bsulkowski/maze-cubed/README.md

# Maze³

**English** · [Polski](README.pl.md)

The classic maze, generalised to three dimensions: cubic cells, passages in
all six directions, no privileged axis. A ball travels inside, and you turn
the cube every way to lead it from the entrance to the exit.

A space like this opens possibilities a flat maze doesn't have — for
example, the route through the maze can tie itself into a knot. In
`lab4_1` the route from entrance to exit, closed up outside the cube, forms
a trefoil.

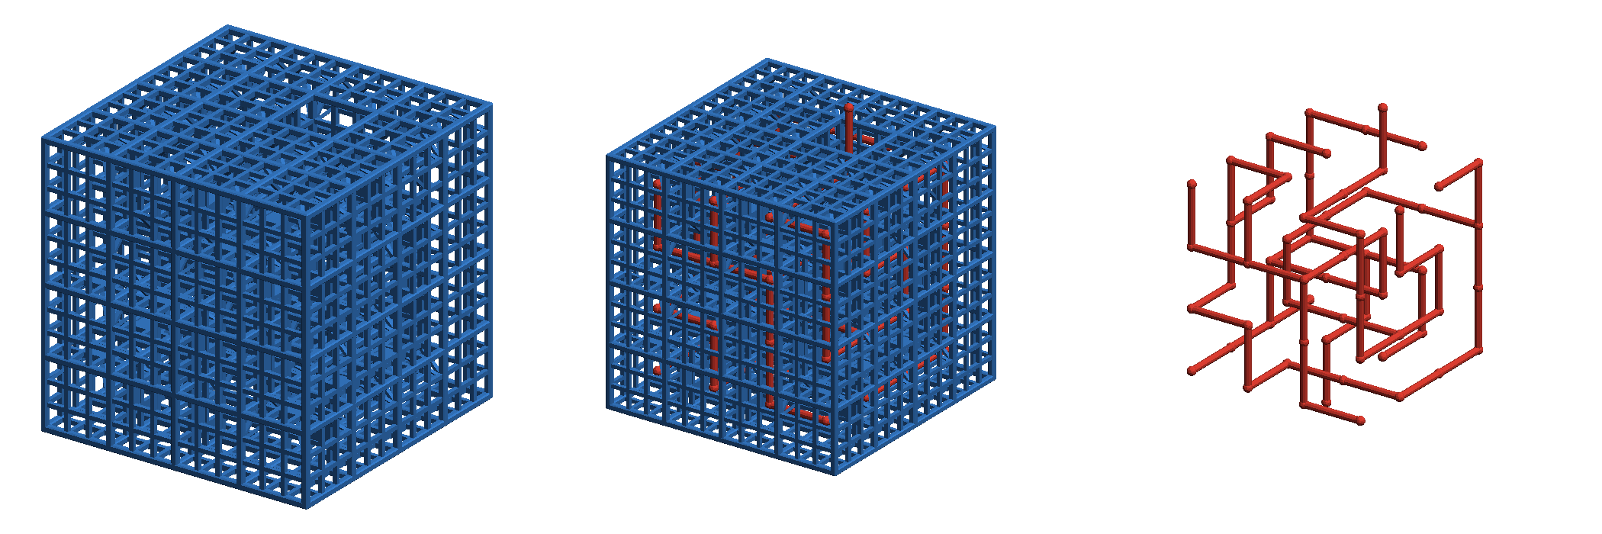
[picture p1: images/lab4_1.png]
Maze lab4_1: model, model with routes, routes alone


## Mazes

| File | Size | Route | Branches | Knot | Notes |
|---|---|---|---|---|---|
| `lab2_1` | 2×2×2, 52 mm, ~16 g | 8 of 8 cells | 0 | — | print test only |
| `lab3_1` | 3×3×3, 77 mm, ~46 g | 14 of 27 cells | 5 | — | warm-up |
| `lab334_1` | 3×3×4, 77×77×102 mm, ~61 g | 19 of 36 cells | 6 | — | a step up |
| `lab344_1` | 3×4×4, 77×102×102 mm, ~79 g | 21 of 48 cells | 8 | — | long dead ends |
| `lab4_1` | 4×4×4, 102 mm, ~102 g | 39 of 64 cells | 9 | trefoil | the main challenge |
| `lab345_1` | 3×4×5, 77×102×127 mm, ~97 g | 39 of 60 cells | 9 | trefoil | unequal sides help orientation |

Weights are for PLA. Every maze is *perfect*: every cell is reachable, there
are no loops, and there is exactly one route from the entrance to the exit.
Ready-to-print STL and 3MF files are in `models/`.

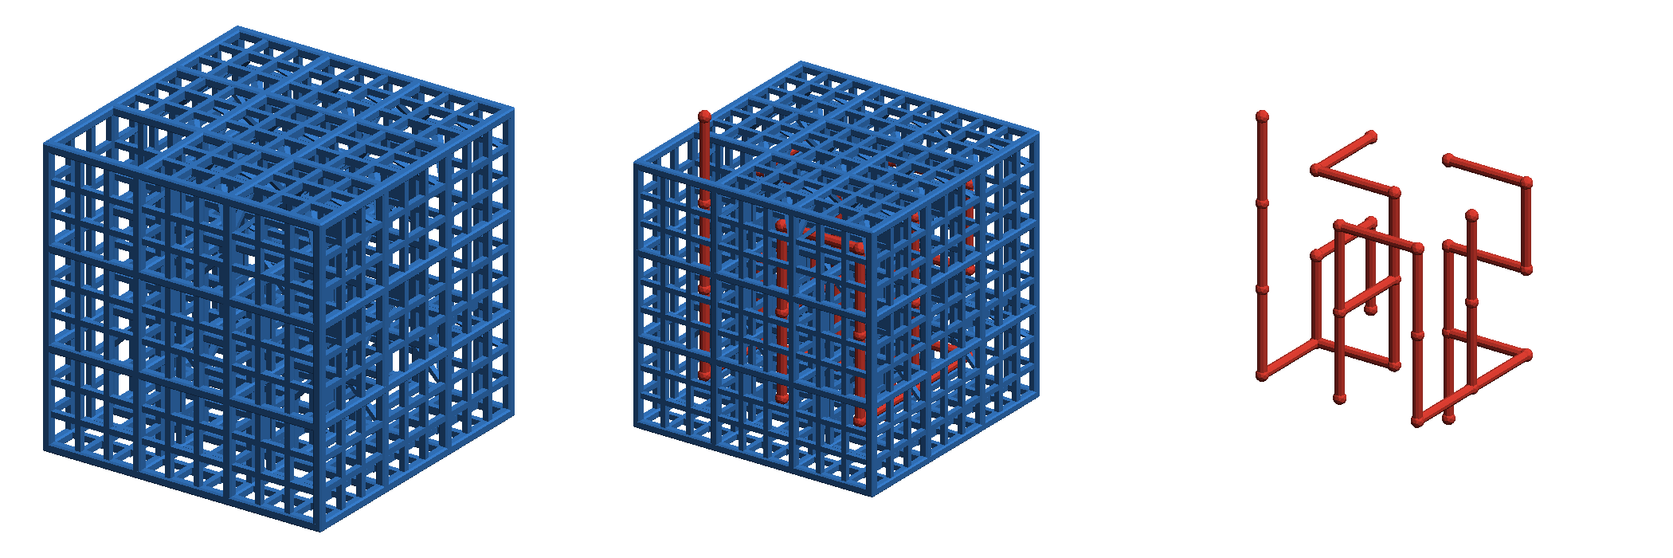
[picture p2: images/lab3_1.png]
Maze lab3_1


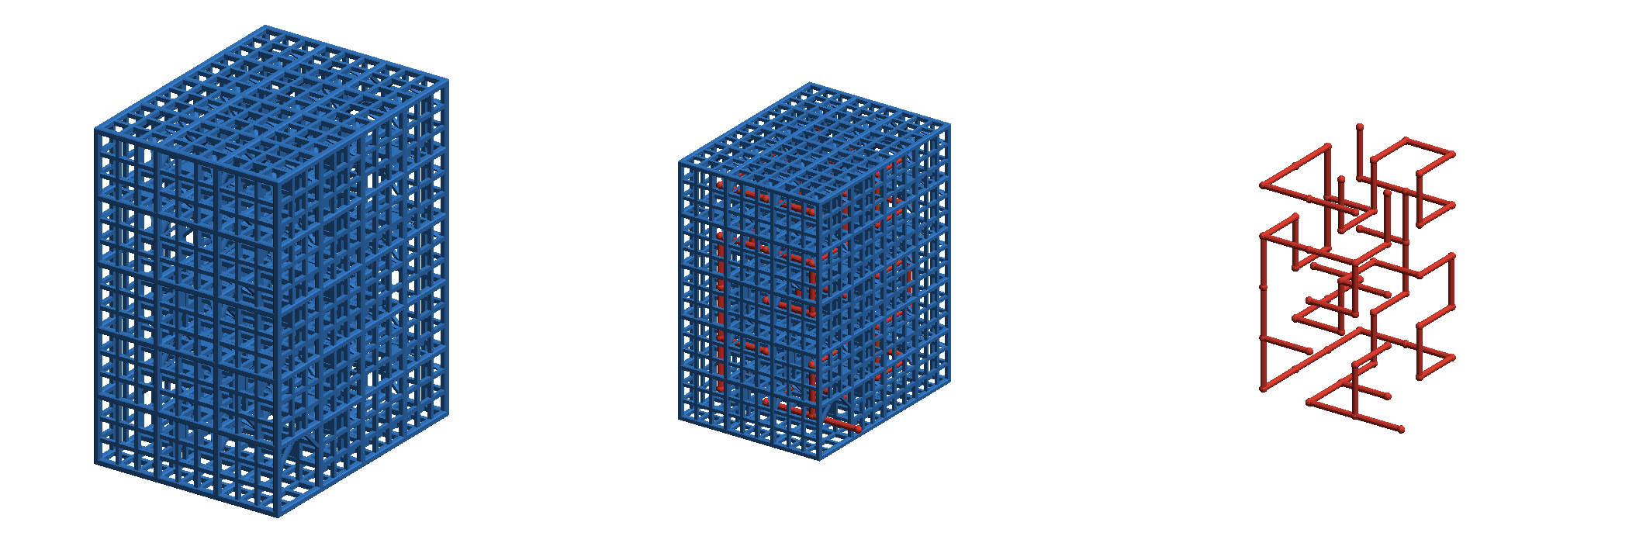
[picture p3: images/lab345_1.png]
Maze lab345_1


## How to play

Every maze has two openings to the outside — in `lab2_1`, `lab3_1` and
`lab4_1` one in the bottom face and one on top, in `lab334_1` and
`lab344_1` one on each of the opposite 3×4 sides, in `lab345_1` one on
each of the large 4×5 sides. Either can be the entrance: drop the ball into
one, then tilt, turn and flip the cube until it comes out of the other.

The ball has a hole through it — Ariadne's thread: pass a thread or a thin
tape through it, and the thread trails behind the ball and shows the way
it has come.

## Printing

- No supports. Print in the orientation from the file.
- Default dimensions are made for a 0.4 mm nozzle: frame bars 2.4 mm
  (6 lines), window grid 1.6 mm (4 lines), 0.4 mm chamfer.
- Every horizontal wall rests on diagonal braces and small pads placed
  exactly under its bridges. The longest bridges are about 8.3 mm
  centre to centre (6.7 mm clear).
- Braces are about 35° from horizontal; good part cooling helps. Their
  undersides may come out slightly rough, which doesn't affect play.
- Designed for a Bambu Lab A1 mini; all models fit its 180 mm build
  volume.

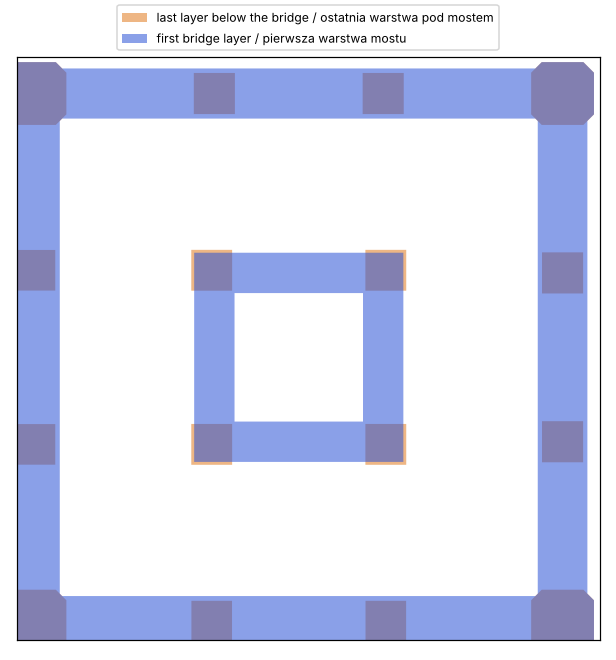
[picture p4: images/bridge_support.png]
Bridge support: brace tops sit exactly under the corners of the pad, where the bridge starts


## The ball

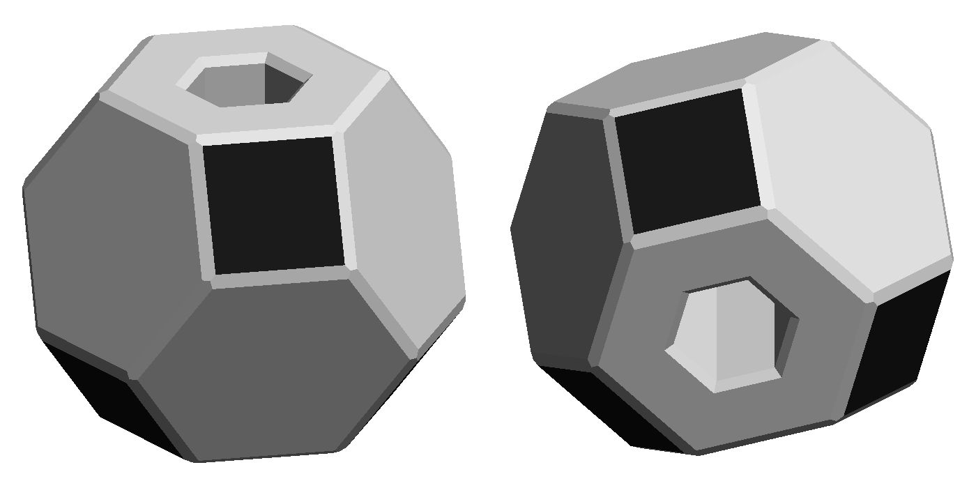
[picture p5: images/ball.png]
Ball


`ball.py` makes a truncated octahedron cut from a 20 mm cube: the cube's
edges and corners cut away, leaving 6 squares and 8 hexagons. It prints
standing on a hexagon without supports (`--on square` for a square face)
and rolls well. All its edges are chamfered by 0.4 mm, like the bars
(`--chamfer`). Straight through the centre, between two opposite hexagons,
runs a hexagonal 5 mm hole for a thread, countersunk at both ends
(`--hole`, `--hole 0` for none). The passages let through a ball of up to
21 mm, so 19–20 mm works best. The cube size is set with `--cube`.

## The knot

The route through the maze starts and ends outside the cube, so closing
it with an arc outside the cube is unambiguous and the loop has a
well-defined knot type. `tools/knot.py` finds the route, closes it, and
computes the Alexander polynomial in several random projections:

```
$ python tools/knot.py mazes/lab4_1.txt
route: 39 cells, from (2, 3, 0) to (3, 3, 5)
projection 0: crossings   9  Δ(t) = t**2 - t + 1   |Δ(−1)| = 3
...
result: trefoil (3₁)
```

A flat maze can't do this: a curve needs three dimensions to be knotted.

## Generator

```sh
pip install -r requirements.txt

python maze_cubed.py mazes/lab4_1.txt     # maze → models/lab4_1.stl, .3mf
python maze_cubed.py --size 4 4 4         # full lattice, no passages
python ball.py                            # ball → models/ball_20mm.stl, .3mf
python tools/knot.py mazes/lab4_1.txt     # knot type of the route
python tools/preview.py models/lab4_1.stl --paths mazes/lab4_1.txt -o images/lab4_1.png
```

The generator also checks the maze itself: whether it covers every cell,
whether it is connected and loop-free, and how many exits it has.

### Path file format

A list of paths, each a list of consecutive cells `[x, y, z]`. Inner cells
have coordinates from 1 to N; 0 or N+1 means an exit to the outside. The
wall between two consecutive cells of a path is open. Branches are written
as separate paths starting from an already visited cell.

```js
pass4x = [
	[ [2, 3, 0], [2, 3, 1], [2, 4, 1], /* … */ [3, 3, 5] ],
	[ [2, 4, 2], [3, 4, 2], [3, 4, 1], [3, 3, 1] ],
	/* … */
];
```

The lattice size is inferred from the paths; it can also be given
explicitly with `--size NX NY NZ`.

### Random mazes

`tools/random_maze.py` generates perfect mazes (uniform random spanning
trees, Wilson's algorithm) and picks the layout that best fits the
criteria: the route goes in all six directions, its length is in a given
range, dead ends are longer rather than single cells, the entrance and
exit are on opposite faces, and optionally the route is (or isn't)
knotted. A given `--seed` always produces the same maze.

```sh
python tools/random_maze.py --size 2 2 2 --seed 3 --min-len 0.5 --max-len 1 -o mazes/lab2_1.txt
python tools/random_maze.py --size 3 3 3 --seed 1 --knot unknot -o mazes/lab3_1.txt
python tools/random_maze.py --size 3 3 4 --seed 5 -o mazes/lab334_1.txt
python tools/random_maze.py --size 3 4 4 --seed 1 -o mazes/lab344_1.txt
python tools/random_maze.py --size 3 4 5 --seed 1 --tries 300 --knot knotted -o mazes/lab345_1.txt
```

A random tree practically never knots its route, so `--knot knotted`
works the other way round: it samples a
strongly tangled Hamiltonian path through the whole lattice (a snake
shuffled with backbite moves), cuts out a segment between opposite faces
whose knot determinant isn't 1, and only then grows the rest of the maze
around it. `--det 5` asks for a figure-eight knot, but at this size it
practically never comes up.

`lab4_1` is the original layout; `lab2_1`, `lab3_1`, `lab334_1`,
`lab344_1` and `lab345_1` were generated with the commands above.

### Construction

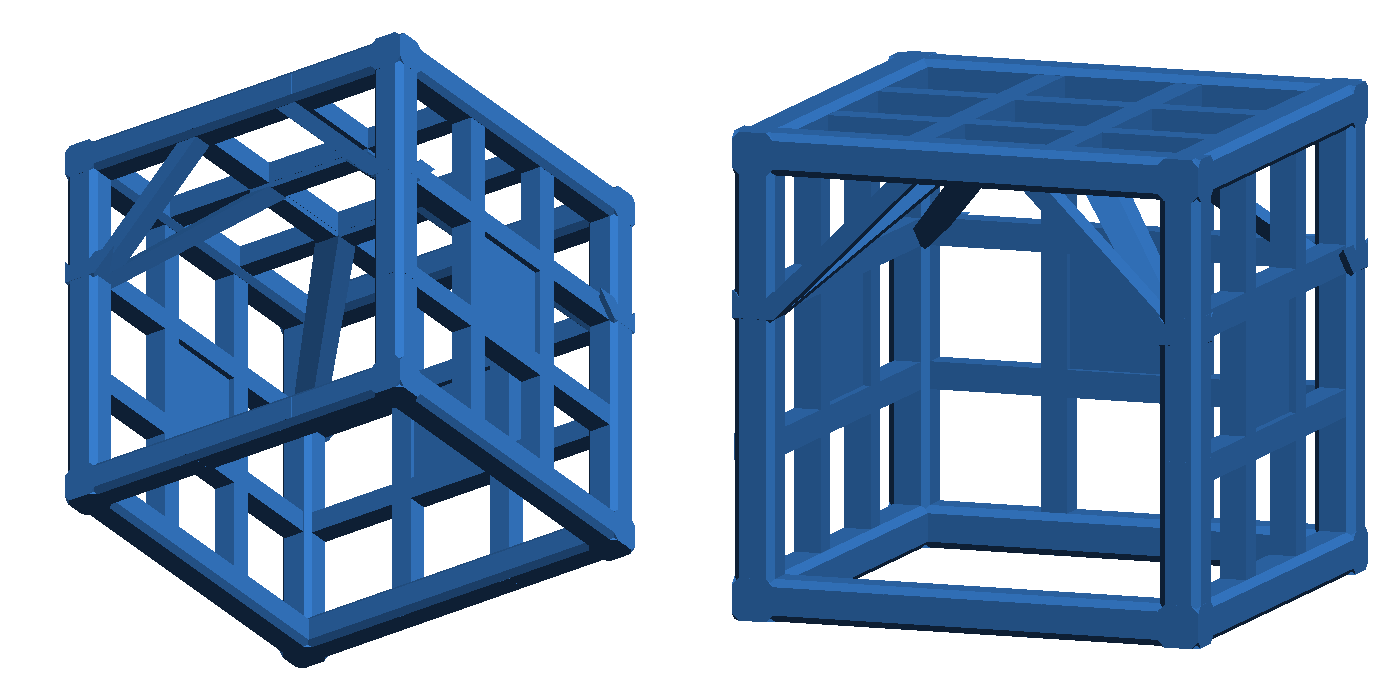
[picture p6: images/cell.png]
A single cell with an open side wall


- **Lattice:** square bars with chamfered edges, 25 mm between axes.
- **Walls:** a grid of square muntins dividing each window into 3 × 3
  panes, centred in the plane of the bars. Open walls have no grid.
- **Plates:** in every closed inner wall the middle pane is filled with a
  0.8 mm plate. The walls inside the maze stand out, and as the cube turns,
  plates at different depths shift against each other, which shows how
  deep they lie. The outer walls of the cube have no plates.
- **Ceiling braces:** 4 per cell, diagonal in plan, from the muntin
  crossings of the ceiling to the nearest corner post. They disappear only
  together with the ceiling. Every horizontal section of a brace is a
  square aligned with the lattice (rotated 45° relative to the brace's own
  axis), and its top lies at the underside of the pad, where the bridge
  starts — under the muntin crossing. Towards the top the brace widens by
  0.4 mm: a slicer takes each layer's outline from the middle of the
  layer, where a leaning brace has already moved outwards, and the
  widening keeps the last layers under the bridge covering the whole
  crossing.
- **Knee braces:** two 45° braces under the top bar of every open side
  wall, ending under the bar above the outer muntin lines. Ceiling braces
  and knee braces meet the posts at the same height.
- **Pads:** under every closed horizontal wall, the frame of the middle
  pane extends down to the level of the bar undersides (one chamfer below
  the muntins). On the bottom face it rests on the print bed.

Bar, chamfer, muntin, cell size and plate thickness can be changed on the
command line (`--rod`, `--chamfer`, `--muntin`, `--edge`, `--plate`;
`--plate 0` leaves the panes empty); the output file then gets a suffix,
e.g. `lab3_1_edge20_plate0`. A muntin can't be wider
than the flat part of a bar (bar − 2 × chamfer).

Touching elements differ in size by a few to a few dozen micrometres
(`EPS`), so that no two faces are coplanar and no face lies on another
element's edge. This keeps the mesh watertight, with no duplicate
vertices, for any dimensions. `EPS` is deliberately not a round number, so
its small multiples never cancel out with round dimensions.

## Repository layout

| Path | Contents |
|---|---|
| `maze_cubed.py` | maze generator (STL + 3MF) |
| `ball.py` | the ball |
| `mazes/` | maze layouts (path files) |
| `models/` | ready-to-print models |
| `tools/knot.py` | knot type of the route |
| `tools/random_maze.py` | random maze in the path file format |
| `tools/preview.py`, `tools/render.py` | PNG previews |
| `images/` | previews |
| `LICENSE` | MIT licence |

## Licence

[MIT](LICENSE) — covers the code and the generated models.
