bsulkowski/maze-cubed/images/lab3_1_rod2.4_chamfer0.4_muntin1.6.png

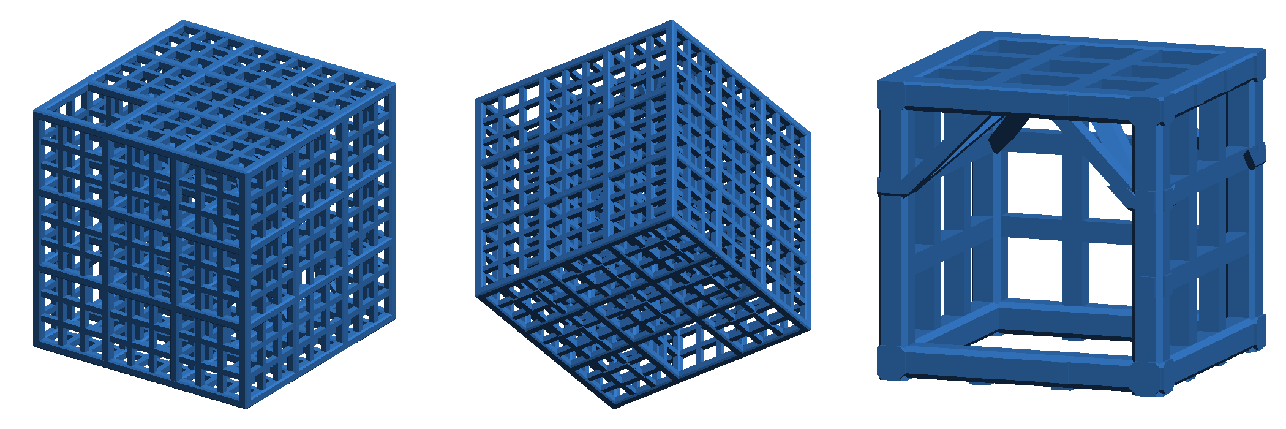
images/lab3_1_rod2.4_chamfer0.4_muntin1.6.png
