bsulkowski/maze-cubed/images/lab3_1_rod3_muntin2.png

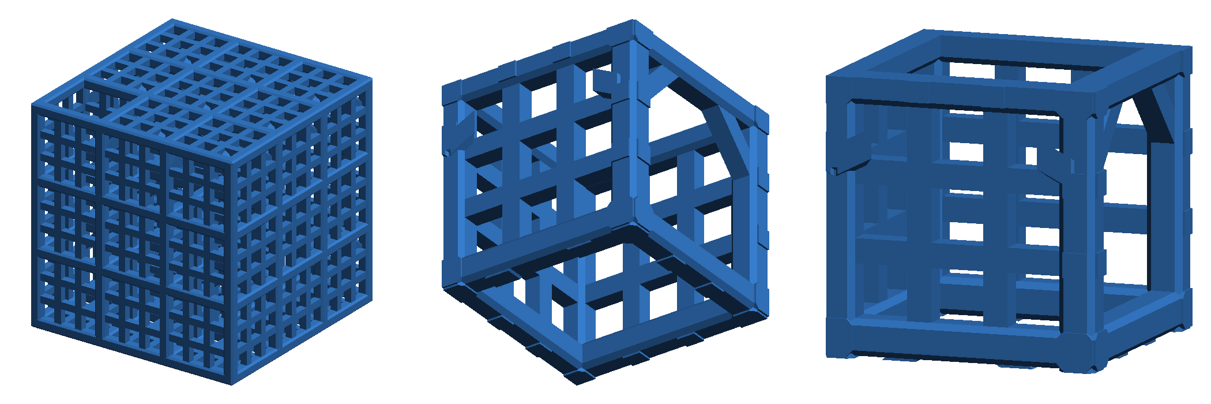
images/lab3_1_rod3_muntin2.png
