bsulkowski/maze-cubed/models/lab2_1.3mf

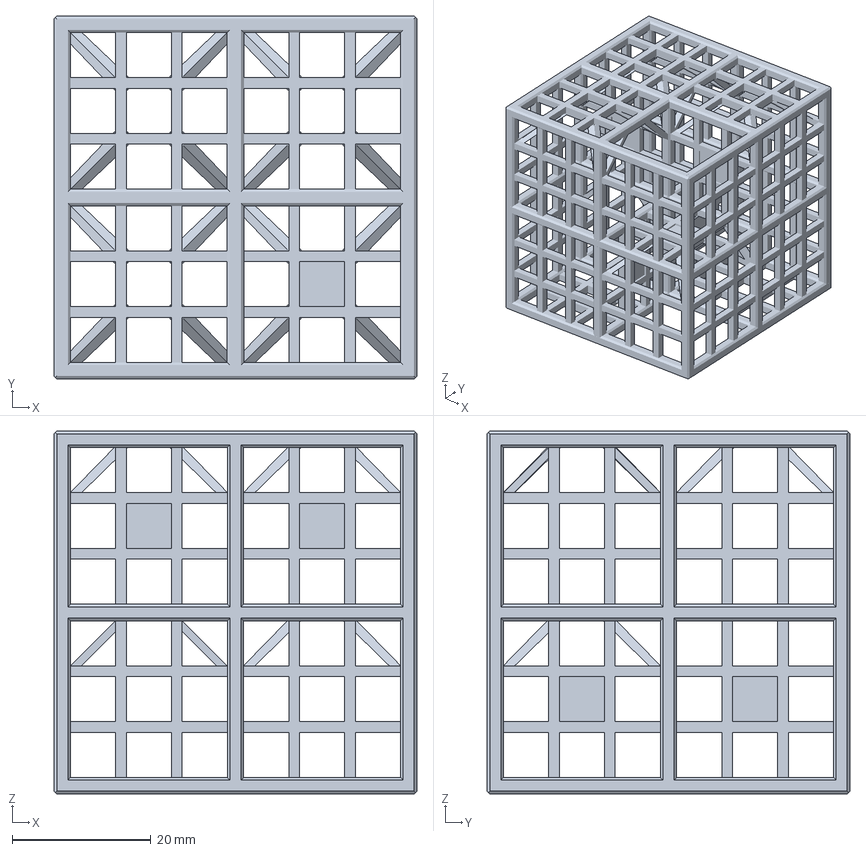
[picture p9: CAD file, 2026-10-20]
models/lab2_1.3mf
52.4 x 52.4 x 52.4 mm
