bsulkowski/maze-cubed/models/lab344_1.3mf

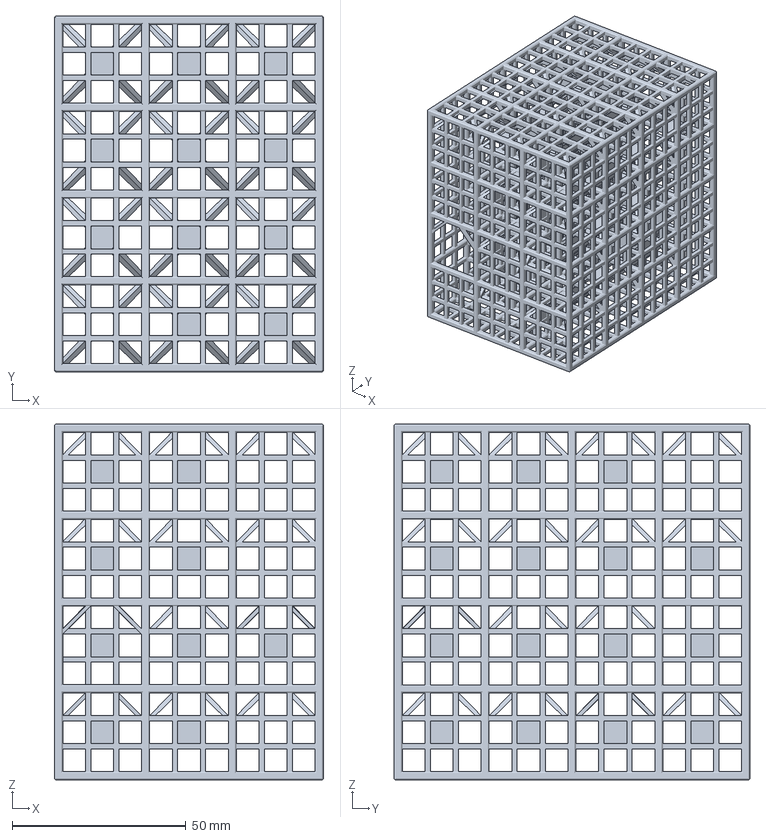
[picture p10: CAD file, 2026-10-20]
models/lab344_1.3mf
77.4 x 102.4 x 102.4 mm
