bsulkowski/maze-cubed/models/lab334_1.3mf

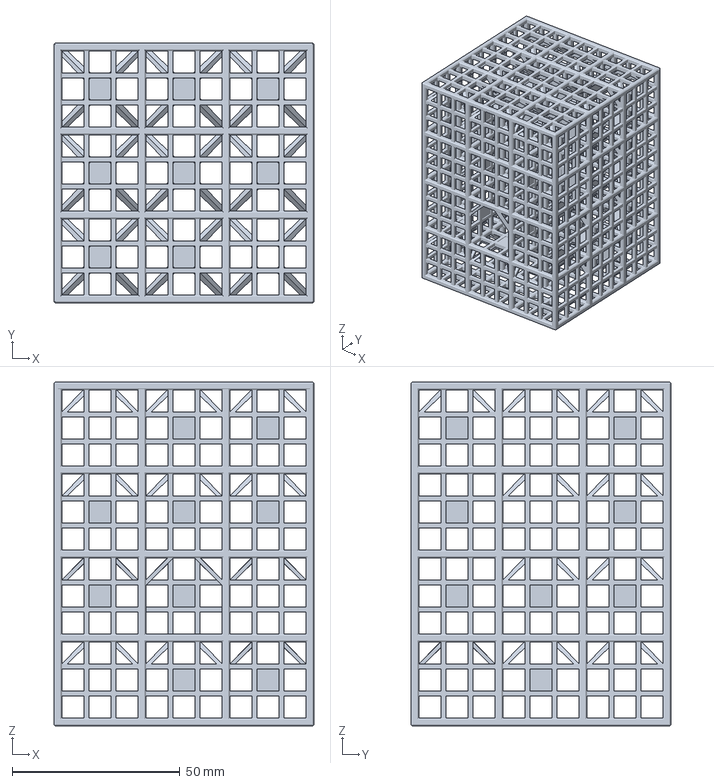
[picture p11: CAD file, 2026-10-20]
models/lab334_1.3mf
77.4 x 77.4 x 102.4 mm
