bsulkowski/maze-cubed/models/lab4_1.3mf

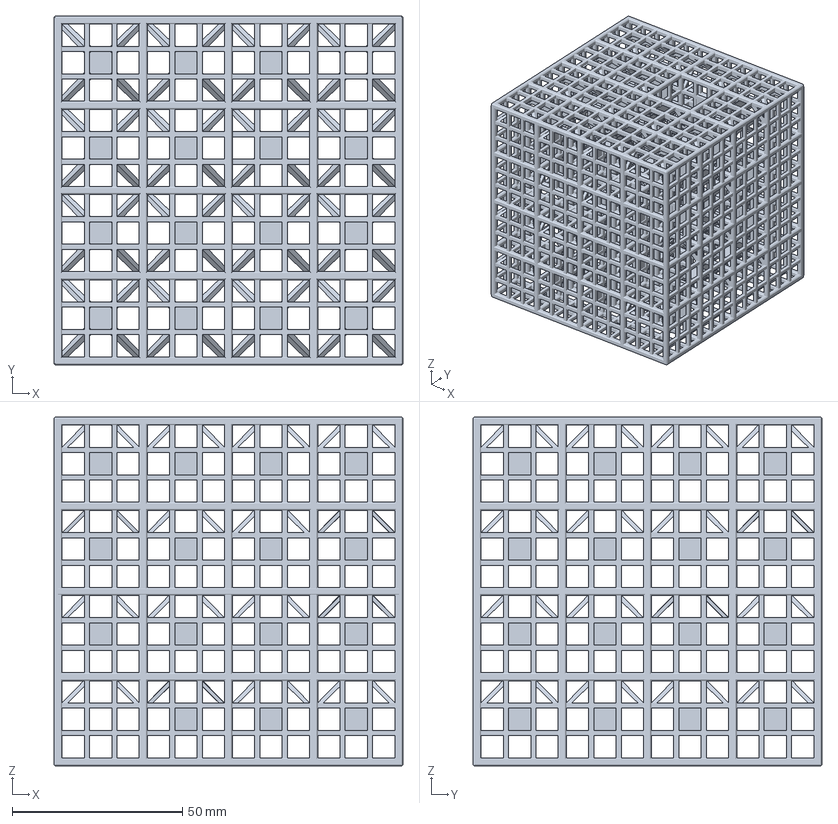
[picture p12: CAD file, 2026-10-20]
models/lab4_1.3mf
102.4 x 102.4 x 102.4 mm
