bsulkowski/maze-cubed/models/lab345_1.3mf

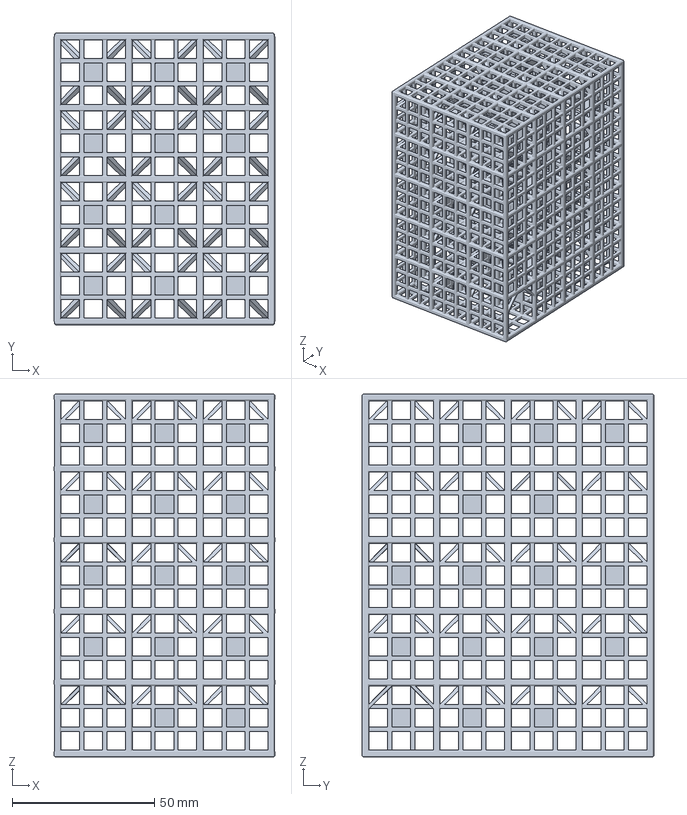
[picture p13: CAD file, 2026-10-20]
models/lab345_1.3mf
77.4 x 102.4 x 127.4 mm
