bsulkowski/maze-cubed/models/lab3_1.3mf

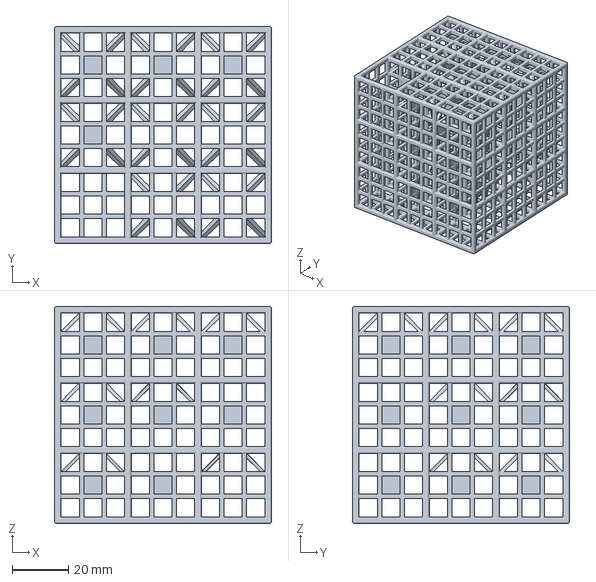
[picture p14: CAD file, 2026-10-20]
models/lab3_1.3mf
77.4 x 77.4 x 77.4 mm
