bsulkowski/maze-cubed/models/ball_20mm.3mf

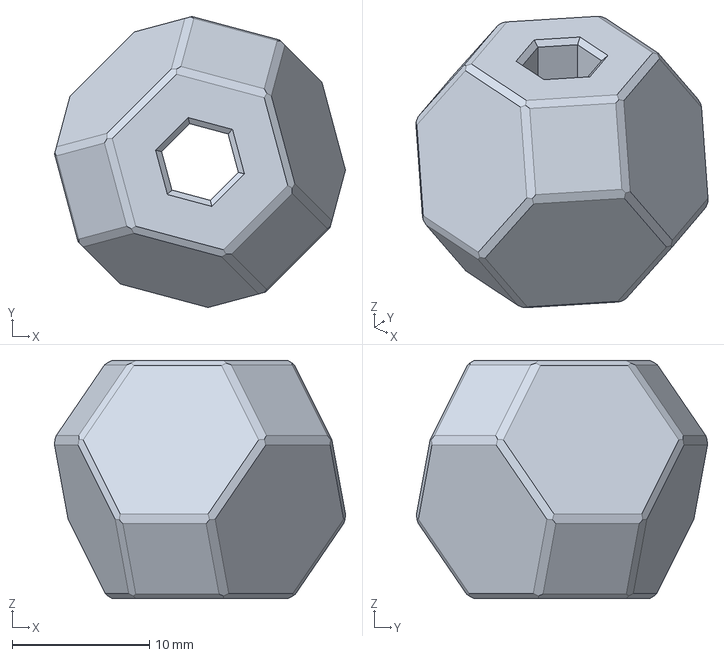
[picture p15: CAD file, 2026-10-20]
models/ball_20mm.3mf
21.2 x 21.2 x 17.3 mm
