bsulkowski/maze-cubed/models/ball_16mm.3mf

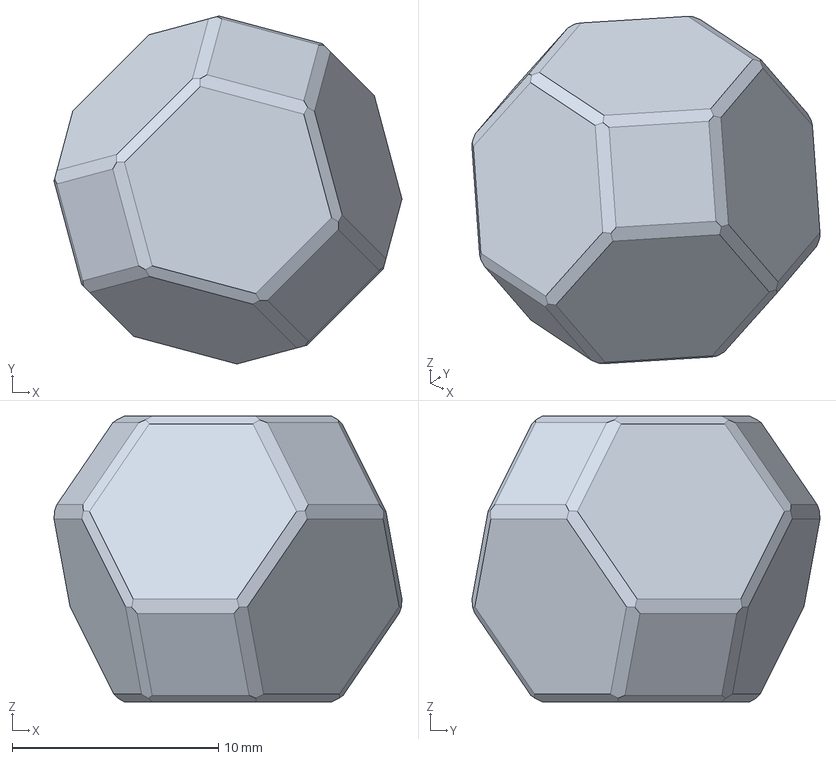
[picture p16: CAD file, 2026-10-19]
models/ball_16mm.3mf
16.9 x 16.9 x 13.9 mm
