bsulkowski/maze-cubed/models/lab4_1_rod2.4_chamfer0.4_muntin1.6.3mf

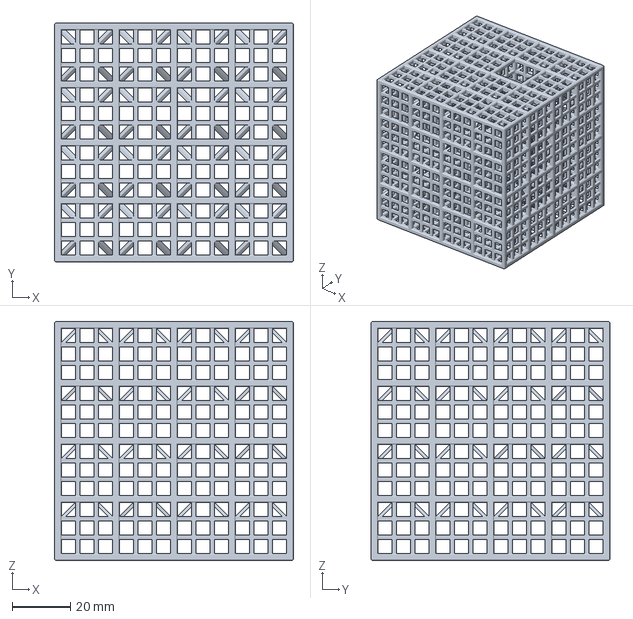
[picture p17: CAD file, 2026-10-14]
models/lab4_1_rod2.4_chamfer0.4_muntin1.6.3mf
82.4 x 82.4 x 82.4 mm
