bsulkowski/maze-cubed/models/lab2_1_rod2.4_chamfer0.4_muntin1.6.3mf

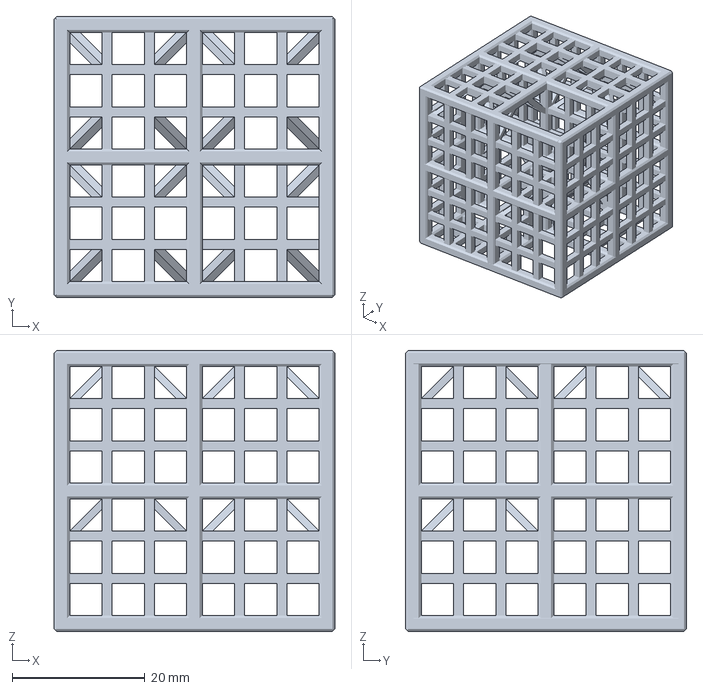
[picture p18: CAD file, 2026-10-13]
models/lab2_1_rod2.4_chamfer0.4_muntin1.6.3mf
42.4 x 42.4 x 42.4 mm
