bsulkowski/maze-cubed/models/lab3_1_rod2.4_chamfer0.4_muntin1.6.3mf

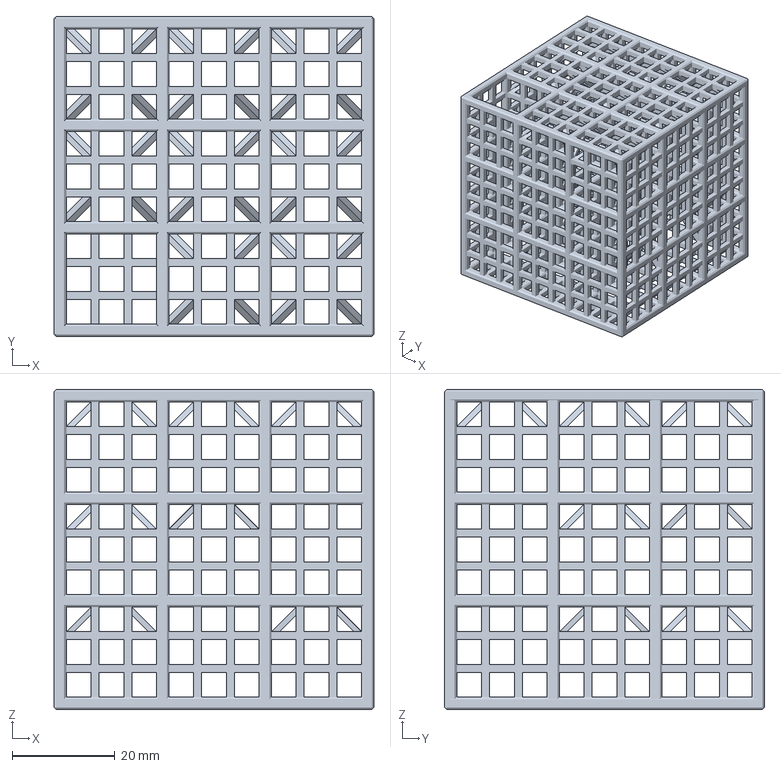
[picture p19: CAD file, 2026-10-13]
models/lab3_1_rod2.4_chamfer0.4_muntin1.6.3mf
62.4 x 62.4 x 62.4 mm
