bsulkowski/maze-cubed/models/lab3_1_rod3_muntin2.3mf

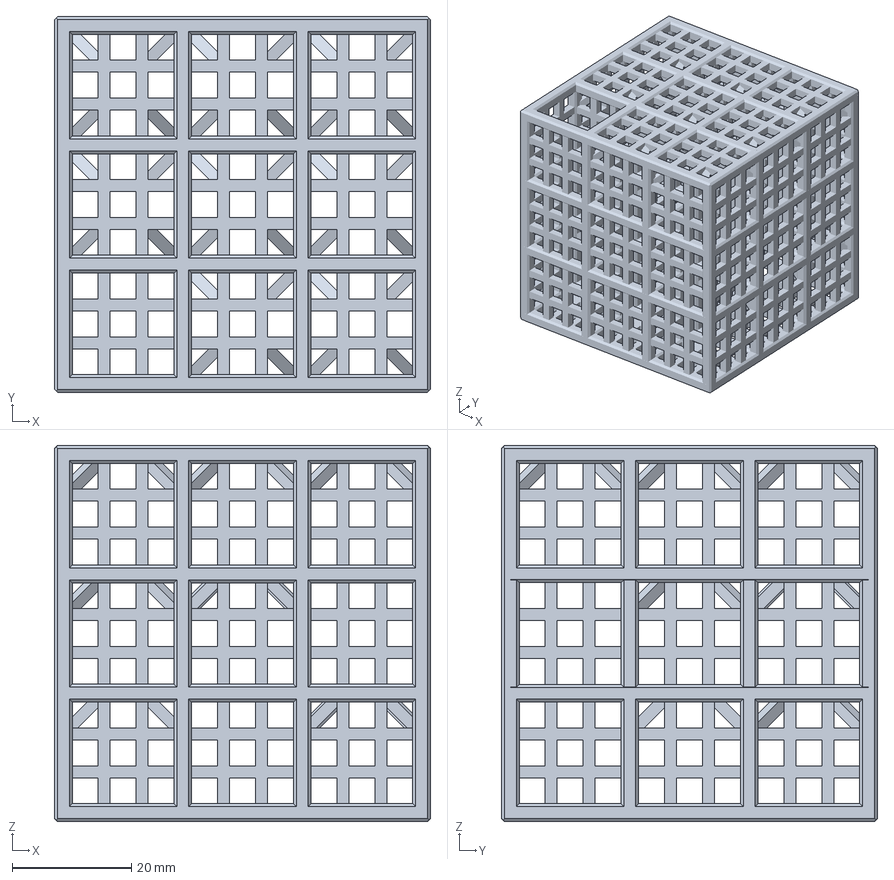
[picture p20: CAD file, 2026-10-13]
models/lab3_1_rod3_muntin2.3mf
63.0 x 63.0 x 63.0 mm
