bsulkowski/maze-cubed/models/ball_10mm.3mf

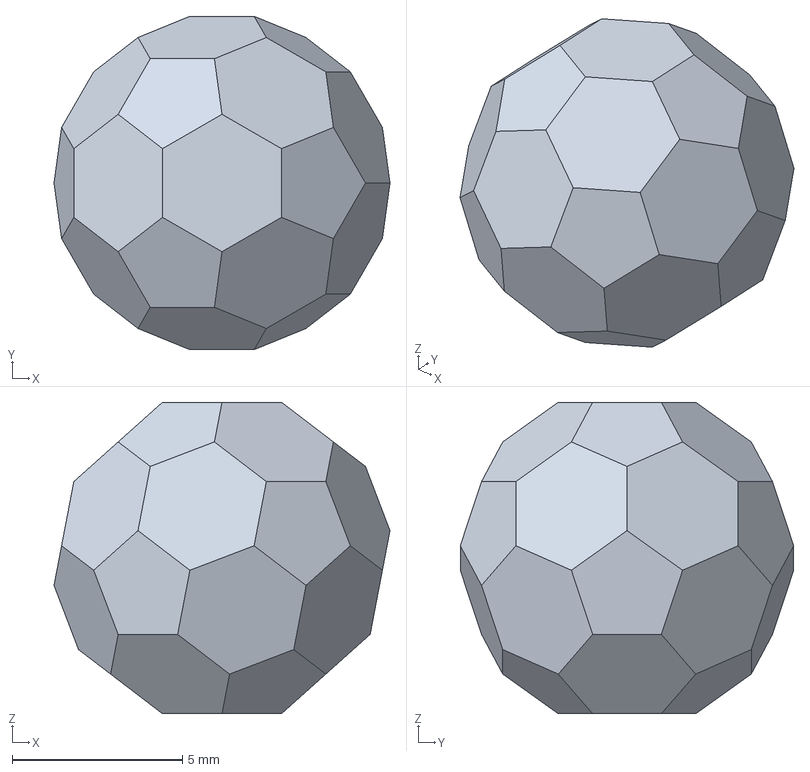
[picture p21: CAD file, 2026-10-13]
models/ball_10mm.3mf
9.87 x 9.79 x 9.15 mm
