bsulkowski/maze-cubed/(list of files, cad)

Other CAD files:
models/ball_10mm.stl
models/ball_16mm.stl
models/ball_20mm.stl
models/lab2_1.stl
models/lab334_1.stl
models/lab344_1.stl
models/lab345_1.stl
models/lab3_1.stl
models/lab3_1_rod2.4_chamfer0.4_muntin1.6.stl
models/lab3_1_rod3_muntin2.stl
models/lab4_1.stl
