bsulkowski/maze-cubed/(commit log)

2026-10-13 Maze³: generator labiryntu 3D, piłka i narzędzia
    - maze_cubed.py: kratownica sześcienna z kratkami szprosów, wspornikami
    sufitu, zastrzałami nad przejściami i oparciem o stół; ścianki na
    ścieżkach z pliku są otwarte; raport o spójności labiryntu
    - ball.py: piłka (dwudziestościan ścięty) ustawiona na sześciokącie
    - mazes/lab4_1.txt: labirynt 4×4×4, droga tworzy trójlistnik
    - models/: gotowe STL i 3MF labiryntu lab4_1 i piłki 10 mm
    - tools/knot.py: typ węzła drogi (wielomian Alexandera)
    - tools/preview.py, tools/render.py: podglądy PNG
    Claude-Session: https://claude.ai/code/session_01RTdHhNZVYtn4SHH7Kkgogr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
2026-10-13 Labirynt 3×3×3 na rozgrzewkę i wydruk próbny
    - mazes/lab3_1.txt: droga 14 z 27 komórek we wszystkich sześciu
    kierunkach, 5 odgałęzień, bez węzła; wejście od spodu, wyjście górą
    - models/lab3_1.stl, .3mf: 62 mm, ok. 19 g PLA
    - tools/random_maze.py: losowy labirynt doskonały (algorytm Wilsona)
    wybierany według kryteriów: kierunki drogi, długość, ślepe zaułki,
    położenie wyjść, opcjonalnie węzeł
    - README: tabela labiryntów
    Claude-Session: https://claude.ai/code/session_01RTdHhNZVYtn4SHH7Kkgogr
2026-10-13 Labirynt 3×4×5 z trójlistnikiem
    - mazes/lab345_1.txt: droga 39 z 60 komórek, zawiązana w trójlistnik;
    wejście i wyjście na przeciwległych ściankach 3×5
    - models/lab345_1.stl, .3mf: 62×82×102 mm, ok. 40 g PLA
    - tools/random_maze.py: tryb --knot knotted losuje najpierw drogę
    (odcinek splątanej ścieżki Hamiltona mieszanej ruchami backbite),
    potem dorasta z niej drzewo; opcja --det wymaga konkretnego wyznacznika
    - tools/knot.py: wspólny diagram dla wielomianu Alexandera i szybkiego
    numerycznego wyznacznika węzła
    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
2026-10-13 Wymiary konstrukcji z wiersza poleceń; wariant próbny 3×3×3
    - maze_cubed.py: --rod, --chamfer, --muntin, --edge; wielkości pochodne
    przeliczane w set_dims(); przyrostek w nazwie pliku przy wymiarach
    innych niż domyślne
    - models/lab3_1_rod3_muntin2: pręt 3 mm z fazką 0,5 mm, szpros 2 mm
    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
2026-10-13 Szczelna siatka przy dowolnych wymiarach; wariant pod dyszę 0,4 mm
    - szprosy, wsporniki i zastrzały są węższe od wymiaru nominalnego o różne
    wielokrotności EPS (20–60 µm), więc nigdy nie leżą na krawędziach
    płaskich ścianek prętów; wcześniej np. szpros 1,6 mm na pręcie 2,4 mm
    z fazką 0,4 mm dawał przez błędy zaokrągleń nieszczelną siatkę
    - modele domyślne przebudowane (szprosy węższe o 45 µm)
    - wariant próbny lab3_1_rod2.4_chamfer0.4_muntin1.6 zamiast rod3_muntin2
    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
2026-10-13 Wsporniki i zastrzały o kwadratowym przekroju poziomym
    - slanted_bar(): ukośny graniastosłup, którego każdy przekrój poziomy to
    kwadrat w osiach kraty; w miejscu podparcia pokrywa się ze skrzyżowaniem
    szprosów (dla wsporników sufitu: przekrój obrócony o 45° względem osi)
    - końce wsporników i zastrzałów rozsunięte w pionie o różne wielokrotności EPS
    - EPS = 0,0047 mm zamiast 0,005: wielokrotności EPS nie trafiają w okrągłe
    wymiary, przez co nie powstają przypadkowe współliniowości (np. pręt 2,5
    ze szprosem 1,3)
    - modele i podglądy przebudowane
    Claude-Session: https://claude.ai/code/session_01RTdHh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
2026-10-13 Labirynt 2×2×2 do testów druku
    mazes/lab2_1.txt i model w wymiarach próbnych (pręt 2,4 mm, fazka 0,4 mm,
    szpros 1,6 mm): 42,4 mm, ok. 13 g PLA. Droga przez wszystkie 8 komórek,
    wejście od spodu, wyjście górą; są wszystkie rodzaje elementów.
    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
2026-10-14 Labirynt 4×4×4 w wymiarach próbnych
    models/lab4_1_rod2.4_chamfer0.4_muntin1.6: pręt 2,4 mm, fazka 0,4 mm,
    szpros 1,6 mm; 82,4 mm, ok. 77 g PLA.
    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
2026-10-14 Domyślne wymiary 2,4/1,6/0,4; dwujęzyczne README
    - maze_cubed.py: pręt 2,4 mm, fazka 0,4 mm, szpros 1,6 mm jako domyślne
    (6 i 4 linie dyszy 0,4 mm); modele i podglądy przebudowane, warianty
    z przyrostkiem usunięte
    - README.md po angielsku (główny) i README.pl.md po polsku, z odnośnikami
    między nimi
    - images/bridge_support.png: przekrój stropu na poziomie mostu
    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
2026-10-14 MIT licence; English comments and console messages
    - LICENSE: MIT, Copyright (c) 2026 Bartosz Sułkowski
    - docstrings, comments, CLI help and console output translated to English
    in maze_cubed.py, ball.py and tools/; generated models and mazes are
    byte-for-byte the same geometry
    - README.md / README.pl.md: licence section, real knot.py output
    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
2026-10-14 Ball: truncated octahedron cut from a 16 mm cube
    The 10 mm football was far too small and hard to print. ball.py now makes
    a truncated octahedron (cube side = width across squares, --cube, default
    16), printed on a square face; preview colours the squares. READMEs: a
    ball of 15–17 mm works best.
    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
2026-10-14 Ball size: 15–16 mm
    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
2026-10-19 Optional plates in the middle pane of closed inner walls (--plate)
    Experimental: marks the walls inside the maze; outer walls stay without
    plates. Output files get a _plate<mm> suffix.
    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
2026-10-19 Optional sparse walls (--sparse)
    Walls keep only the frame of the middle pane, plus the vertical muntins in
    vertical walls (they carry the top bar, so bridges stay a third of a cell);
    the bottom face keeps muntins along one axis to hold its frames. Output
    files get a _sparse suffix.
    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
2026-10-19 Ball: optional octagonal through hole for a thread (--hole)
    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
2026-10-19 Ball stands on a hexagon by default; hole shaped like the face it goes through
    More contact with the bed (2.6× a square). --on square keeps the old
    orientation; a hole through squares stays octagonal.
    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
2026-10-19 Ball: 0.4 mm chamfer on all edges and countersinks at the hole (--chamfer)
    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
2026-10-20 New defaults: 25 mm cells, plates in closed inner walls, 20 mm ball with a thread hole
    The bigger cells and the plates make the inside of the maze much easier to
    read (print-tested). Sparse walls dropped: they made the cube look chaotic.
    All models and previews regenerated; READMEs updated.
    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
2026-10-20 Braces widen by 0.4 mm towards the top
    A slicer takes each layer's outline from its middle, where a leaning brace
    has already moved outwards, so the pad above printed off-centre. With the
    widening the last layers under the bridge cover the whole crossing.
    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
2026-10-20 Knee braces without the widening (they printed fine)
    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
